InovLabs/telemetria-carros-solares/hardware/caixa-3d.md

---
description: >-
  Ficheiros de desenho e recomendações de impressão 3D para proteção mecânica do
  circuito.
---

# Caixa Protetora 3D

Para garantir que o circuito eletrónico fica isolado contra contactos acidentais com o chassis metálico ou com o habitáculo do carro solar, deve ser instalada uma caixa protetora.

* **Ficheiro STL para Impressão:** [Descarregar Caixa Telemetria (STL)](https://github.com/InovLabs/telemetria-carros-solares/blob/main/hardware/Caixa%20Telemetria.stl)
* **Modelo 3D Paramétrico Editável:** [Tinkercad — Caixa Telemetria](https://www.tinkercad.com/things/4hU2wSKMU5R-caixa-telemetria)

***

### Parâmetros Recomendados de Impressão

{% hint style="danger" %}
**Não uses filamento PLA comum:**\
Dentro do habitáculo fechado de um carro solar em dias de sol e corrida, as temperaturas podem ultrapassar os **50 °C a 60 °C**. O plástico PLA perde a rigidez e deforma-se. Imprime a caixa em **PETG** ou **ABS**.
{% endhint %}

* **Material:** PETG (ideal) ou ABS.
* **Preenchimento (Infill):** 25% a 30% em padrão Gyroid ou Grid.
* **Paredes Perimetrais:** Pelo menos 3 camadas para garantir roscas firmes ao apertar parafusos.
