InovLabs/telemetria-carros-solares/SUMMARY.md

# Sumário

* [Visão Geral](README.md)

## Hardware e Montagem
* [Lista de Material](hardware/lista-material.md)
* [Esquema Elétrico e Ligações](hardware/esquema-eletrico.md)
* [Ligação ao MPPT Victron](hardware/victron-mppt.md)
* [Caixa Protetora 3D](hardware/caixa-3d.md)

## Software e Firmware
* [Raspberry Pi Pico (MicroPython)](firmware/raspberry-pi-pico.md)
* [Rádio LoRa (Meshtastic)](firmware/meshtastic-lora.md)
* [Estação Base & Grafana](software/estacao-base.md)

## Expansão & Desafio Escolar
* [Personalização & Novos Sensores](avancado/personalizacao-sensores.md)

## Suporte
* [Diagnóstico & FAQ](suporte/faq.md)
