InovLabs/telemetria-carros-solares/hardware/Caixa Telemetria.stl

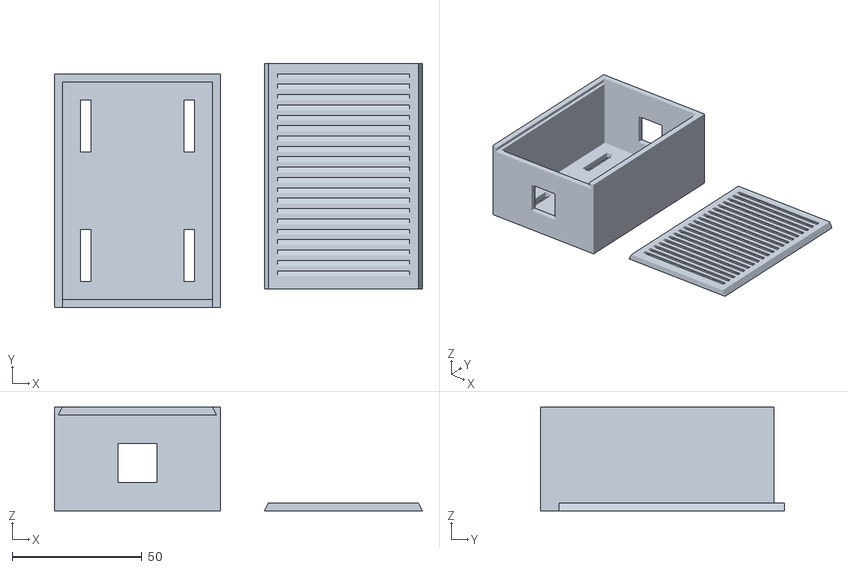
[picture p8: CAD file, 2026-11-04]
hardware/Caixa Telemetria.stl
142.0 x 94.0 x 40.0
